shadowjohn/115ATTiny85RPMGenerator/電路圖/V1/B0505S-1W.png

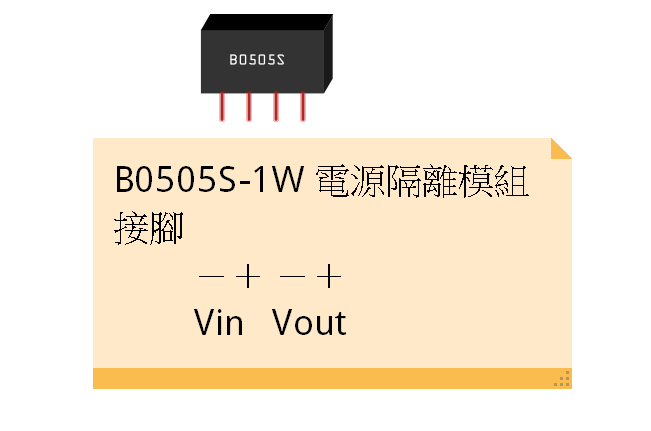
電路圖/V1/B0505S-1W.png
