shadowjohn/115ATTiny85RPMGenerator/電路圖/V1/S1.png

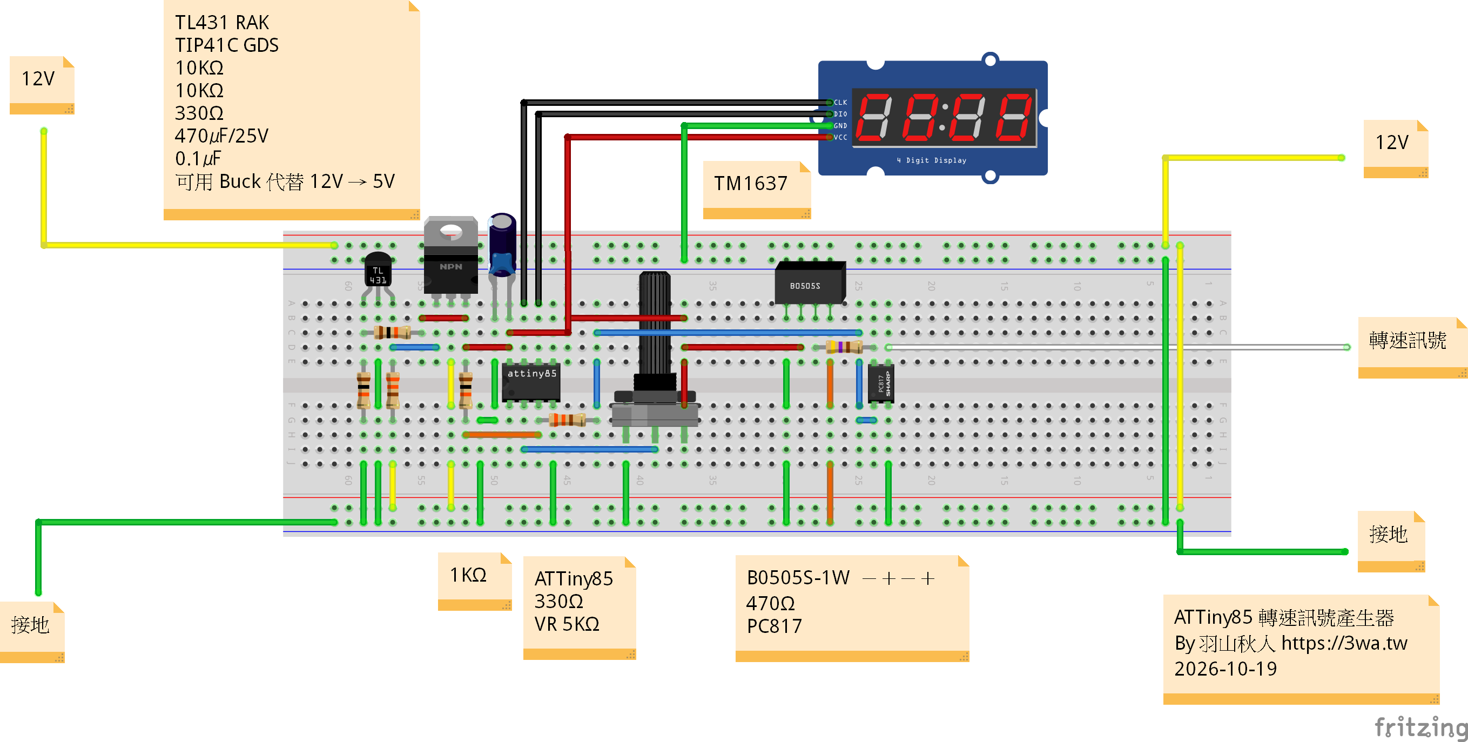
電路圖/V1/S1.png
