shadowjohn/115ATTiny85RPMGenerator/電路圖/V1/電路圖2596.png

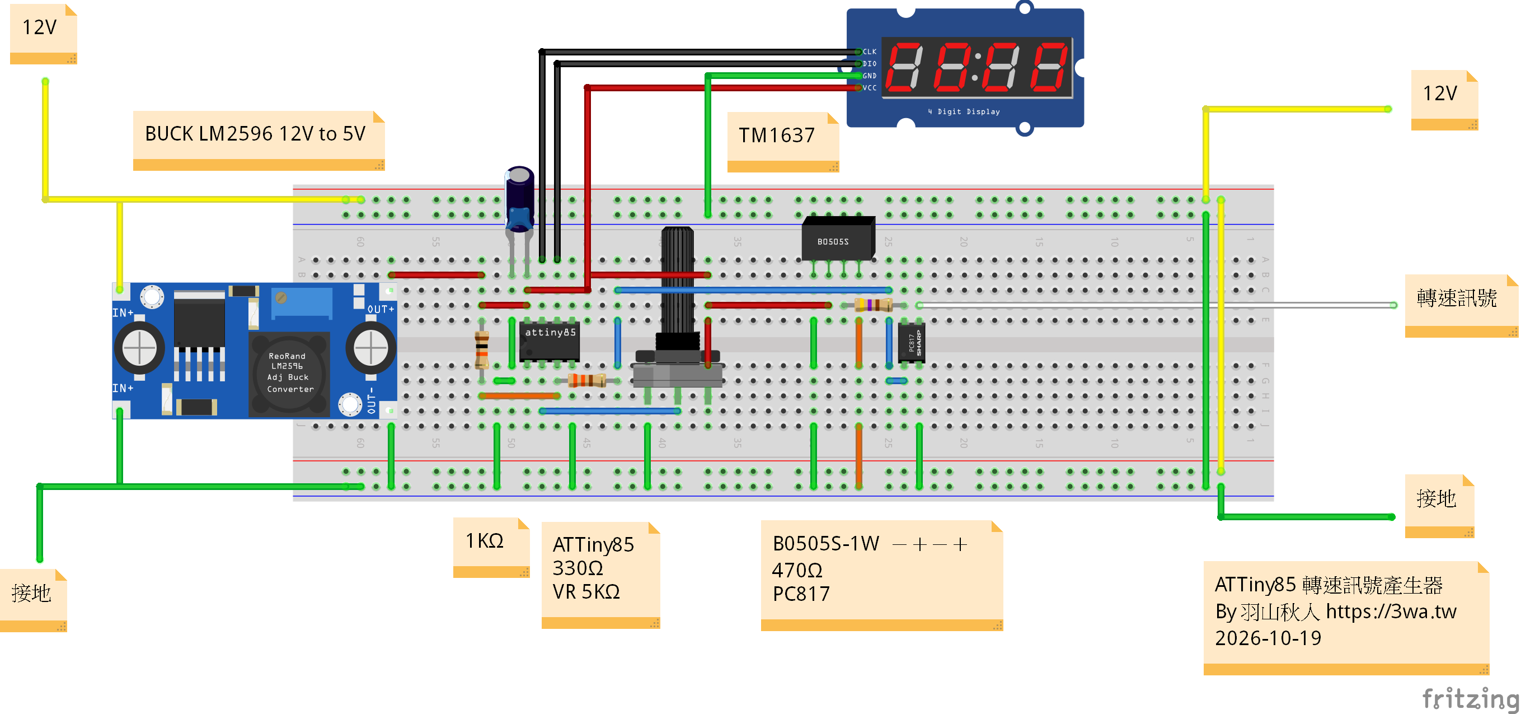
電路圖/V1/電路圖2596.png
