shadowjohn/115ATTiny85RPMGenerator/(list of files, drawings)

Other design files:
電路圖/V1/B0505S-1W.fzz
電路圖/V1/電路圖2596.fzz
電路圖/V1/電路圖.fzz
電路圖/V2-V3/電路圖2596.fzz
