shadowjohn/115ATTiny85RPMGenerator/(commit log)

2026-10-13 初次簽入
    [電路圖.fzz]
2026-10-14 更新，使用 B1212S
    [電路圖.fzz]
2026-10-15 修正 偵測 VR 的頻率不夠快，所以在調轉速時會覺得有點慢半拍 還有另一個問題是在轉 VR 時，感覺轉速在變化，好像都會先掉轉再往上，不知道是不是換算時發生頻率會斷掉再生成的問題? 轉速改成 x10 150 代表 1500rpm
    [115ATTiny85RPMGenerator.ino, regression.cpp]
2026-10-17 更新電路圖
    [電路圖.fzz]
2026-10-19 增加電路
    [B0505S-1W.fzz, 電路圖.fzz, 電路圖2596.fzz]
2026-10-31 加入 V3 程式
    V3 按鈕依序切換：
    1. 階梯手動：每格 500 RPM。
    2. 平順手動：VR 對應 0～14000 RPM，兩端保留停留區。
    3. 自動爬格子：原本的升降循環。
    切換時顯示 1／2／3 約 0.8 秒，再恢復轉速。
    [B0505S-1W.fzz, 電路圖.fzz, 電路圖2596.fzz]
2026-11-01 增加 V2-V3 電路圖
    [電路圖2596.fzz]
